nous-/soul-urn/(list of files, cad)

Other CAD files:
hardware/stl-export/shell_colored-pattern.stl
hardware/stl-export/electronics-carrier.stl
hardware/stl-export/wave-lid.stl
hardware/stl-export/shell_white-diffuser.stl
hardware/stl-export/polyfill-guard.stl
hardware/stl-export/sensor-capture-spacer.stl
hardware/stl-export/urn-stand.stl
hardware/stl-export/acoustic-tube.stl
hardware/stl-export/bottom-cup.stl
hardware/mesh/soul-urn.blend
